experimentool/LTC2945-multiple-voltage-scanner/IMG_20190122_145149.jpg

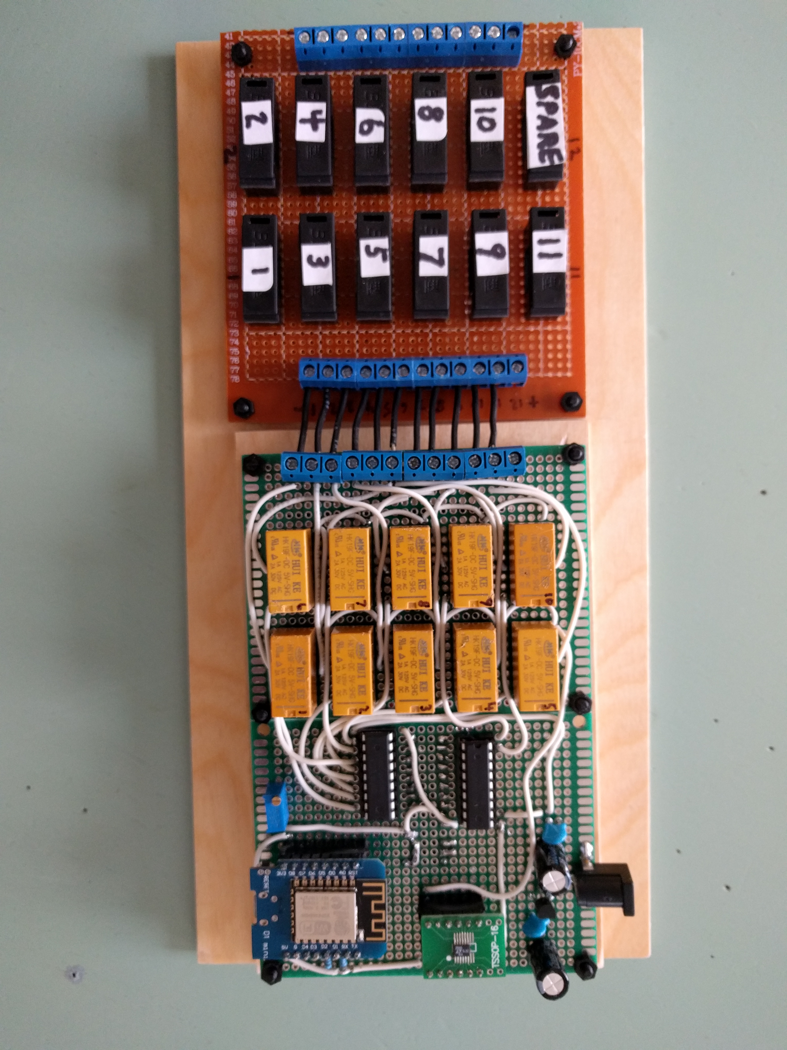
IMG_20190122_145149.jpg
