experimentool/LTC2945-multiple-voltage-scanner/Schematic_LTC-BATTERY-VOLTAGES-SCANNER_Sheet-1_20190204062235.pdf

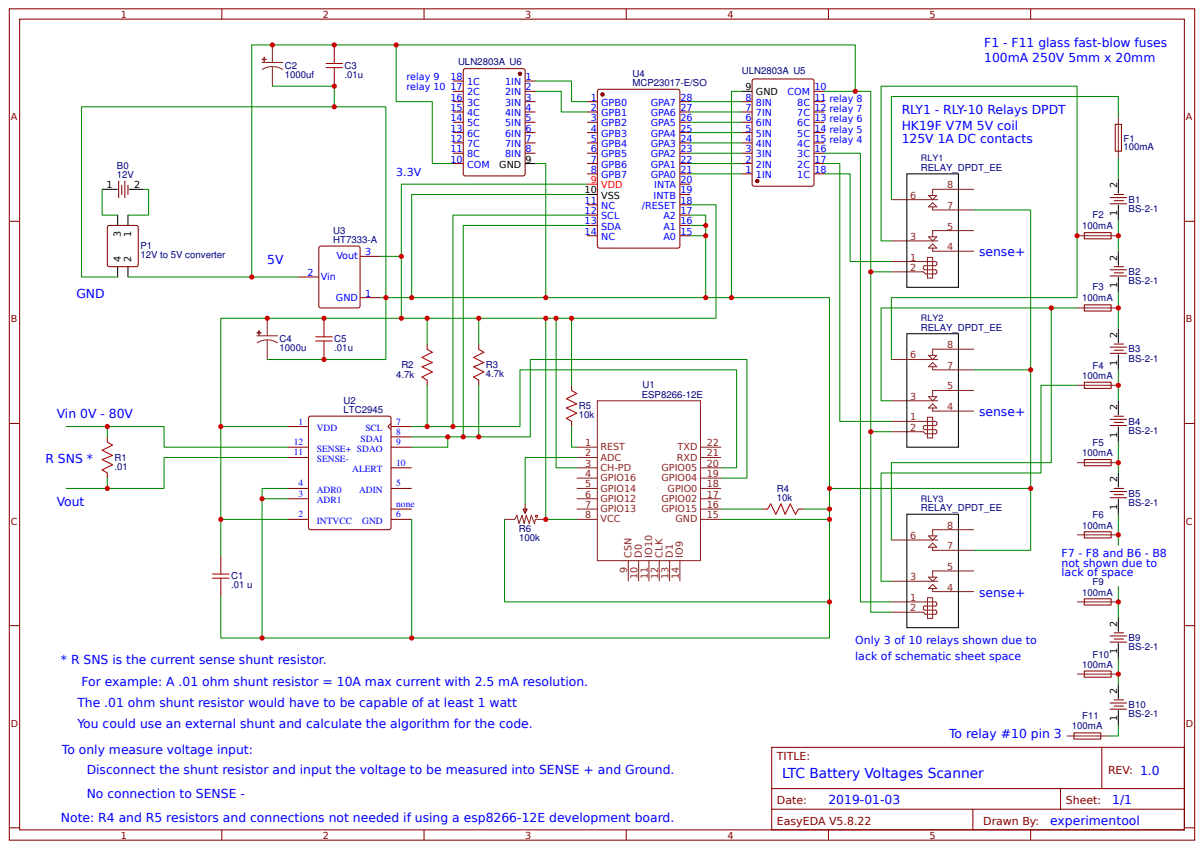
[picture p2: page 1]

F1 - F11 glass fast-blow fuses

Only 3 of 10 relays shown due to
lack of schematic sheet space

* R SNS is the current sense shunt resistor.
For example: A .01 ohm shunt resistor = 10A max current with 2.5 mA resolution.
The .01 ohm shunt resistor would have to be capable of at least 1 watt
You could use an external shunt and calculate the algorithm for the code.
To only measure voltage input:
Disconnect the shunt resistor and input the voltage to be measured into SENSE + and Ground.
No connection to SENSE -
Note: R4 and R5 resistors and connections not needed if using a esp8266-12E development board.
